JTech-CO/Smart-Cart-Wiring/tests/desktop.png

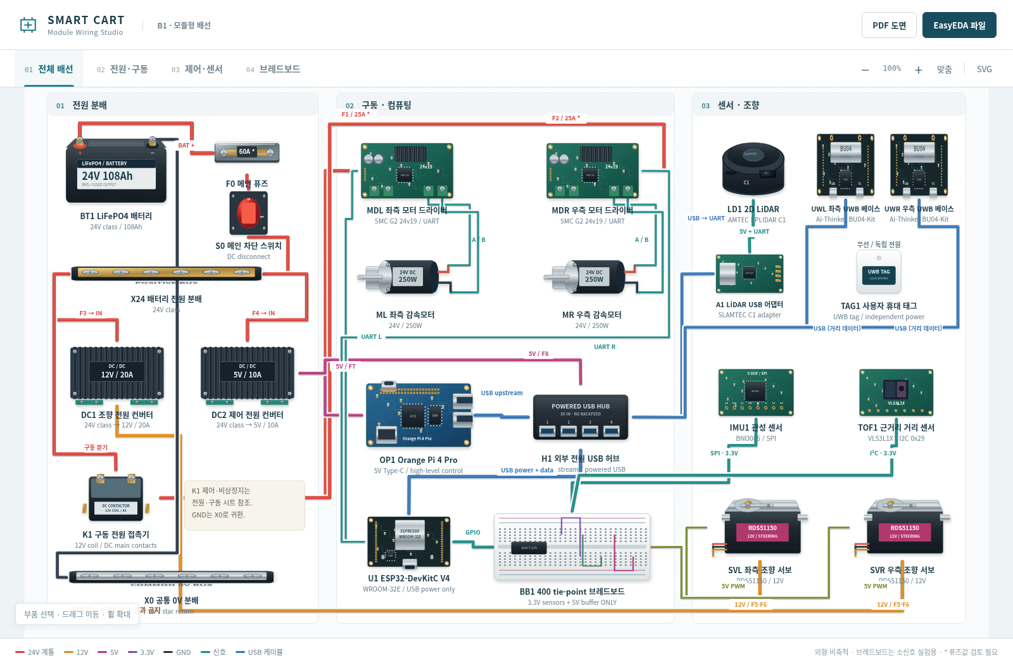
tests/desktop.png
