JTech-CO/Smart-Cart-Wiring/docs/SOURCES.md

# Primary sources / 기본 참조

검토일: 2026-09-13. 정확한 구매품 사양은 해당 제조사의 구매 모델 문서로 재확인합니다.

## S01 | Smart-Cart repository / 2b4b8fea6909e4f76b4a52b02c5075c3f478097b

https://github.com/JTech-CO/Smart-Cart/tree/2b4b8fea6909e4f76b4a52b02c5075c3f478097b

## S02 | Pololu G2 SMC user guide

https://www.pololu.com/docs/0J77/all

## S03 | ESP32-DevKitC V4 power and J2/J3 pin tables

https://docs.espressif.com/projects/esp-dev-kits/en/latest/esp32/esp32-devkitc/user_guide.html

## S04 | Adafruit BNO085 pinouts and SPI mode

https://learn.adafruit.com/adafruit-9-dof-orientation-imu-fusion-breakout-bno085/pinouts

## S05 | Pololu VL53L1X carrier #3415

https://www.pololu.com/product/3415

## S06 | Ai-Thinker BU04-Kit specification v1.1.0, p9 USB port

https://en.ai-thinker.com/Uploads/file/20241018/20241018150326_27432.pdf

## S07 | TI SN74AHCT125 datasheet

https://www.ti.com/lit/ds/symlink/sn74ahct125.pdf

## S08 | EasyEDA Standard document format

https://docs.easyeda.com/en/DocumentFormat/EasyEDA-Format-Standard/index.html

## S09 | EasyEDA Pro import EasyEDA Standard JSON / ZIP

https://prodocs.easyeda.com/en/import-export/import-easyeda/

## S10 | EasyEDA Pro KiCad 5.1 import

https://prodocs.easyeda.com/en/import-export/import-kicad/

## S11 | Infineon BTS7960 operating voltage

https://www.infineon.com/dgdl/BTS7960_Datasheet.pdf

## S12 | SLAMTEC C1 datasheet

https://d229kd5ey79jzj.cloudfront.net/3157/SLAMTEC_rplidar_datasheet_C1_v1.0_en.pdf

RDS51150, 배터리/BMS, DC-DC, 허브, 접촉기는 정확한 구매 SKU가 없어 조건부 항목으로 표기했습니다.
