JTech-CO/Smart-Cart-Wiring/docs/ASSEMBLY-KR.md

# B1 모듈 조립 참조 및 미확정 항목

## 설계 기준과 출처

Smart-Cart 저장소 main의 `2b4b8fea6909e4f76b4a52b02c5075c3f478097b`를 참조했습니다. 해당 저장소는 사진 기반 절차적 WebGL 뷰어이며 전장 회로나 FreeCAD 치수 원본이 아닙니다. 코드나 기존 이미지의 라이선스를 새로 지정하거나 그대로 가져오지 않았습니다. 본 도면의 외형 재구성 역시 실측·제품 CAD가 아닙니다.

원래 카트의 후륜 차동 구동·전륜 자유 캐스터와 조향 서보 2개 요구를 구분합니다. 두 서보는 보존했으나 조향 링크·조향 끝점·차동 구동과의 운동학을 정하기 전에는 동력 조향을 활성화하지 않습니다.

## 배선 기준

전력 하네스는 BAT+, BUS24, DRIVE24, P12, P5, GND로 구분합니다. 전원 -의 공통화와 서로 다른 +전원 합선은 다릅니다. 컨버터는 비절연형을 가정했으며 다른 제품 사용 시 공통 접지/통신 기준을 다시 검토합니다. 모터 A/B는 H브리지 출력이라 어느 쪽도 상시 GND가 아닙니다.

SBC·서보·모터 전류는 브레드보드를 거치지 않습니다. 각 귀환은 X0의 적절한 전력 분기로 보내며 신호 점퍼를 대전류 귀환으로 이용하지 않습니다. 그림의 케이블 굵기는 시각 구분이고 AWG 선정값이 아닙니다. 길이, 주위 온도, 번들링, 단자 전류, 전압 강하, 퓨즈 시간-전류 곡선과 단락 차단용량을 확보한 뒤 도체 단면을 확정합니다.

## 전원과 정지

BT1은 기존 24V 클래스 108Ah 요구입니다. 배터리 실모델·직렬 수·BMS 방전/충전 허용 전류·충전 상한은 미확정입니다. 8S LiFePO4로 구성하면 공칭 25.6V이며 최대 충전 전압은 배터리 제조사에 따라 확인해야 합니다. 용량 Ah를 허용 방전 A로 취급하지 않습니다.

BTS7960의 정상 입력 전압 범위(5.5~27.5V)는 완충 8S 배터리와 여유가 부족하므로 기본 구성에서 제외했습니다. SMC G2 24v19는 조건부 참조이며, 실제 연속 전류·스톨·방열·재생 제동 검증이 필요합니다. 제조사의 포함 단자대 15~16A 안내 때문에 25A 퓨즈가 적힌 분기를 해당 단자대에 그대로 승인하지 않았습니다. 적합한 고전류 접속 또는 드라이버 변경이 필요합니다. [S02, S11]

DC1: 12V/20A, DC2: 5V/10A는 목표 출력입니다. 입력 허용 범위가 완충 및 과도전압을 포함해야 하고, 연속 출력 열조건·단락·과전압 보호·부하 급변 응답은 실모델로 확인해야 합니다. 12V 서보 2개의 지속 스톨을 퓨즈만으로 보호할 수는 없습니다.

K1은 12V 코일과 독립 NO 보조접점이 있는 DC 접촉기를 가정합니다. P12→F9→S1 NC→(S2 NO || K1 13-14)→A1, A2→GND가 자기유지 기능 회로입니다. Z1은 K1 지정 코일 억제기입니다. S1 복귀만으로 코일을 재여자하지 않지만, 단일 접점 용착·배선 단락까지 안전을 보장하는 인증 회로가 아닙니다. 전원 차단은 제동이 아니며 조향 전원은 유지됩니다. K1 개방/배터리 완충/BMS 차단 시 회생 에너지 처리와 별도 브레이크를 반드시 설계해야 합니다.

## 제어·센서

ESP32-DevKitC V4 WROOM-32E는 허브 USB로만 급전합니다. 5V 헤더와 다른 USB 전원을 추가 병렬 급전하지 않습니다. J2/J3 번호는 Espressif V4 보드의 표 기준이며 다른 DevKit·WROVER·클론은 회로/핀맵을 다시 확인합니다. [S03]

Orange Pi는 외부 5V 전원 입력을 사용합니다. 외부 전원 4포트 허브는 upstream 역급전 방지와 포트별 전류 조건이 있는 제품이어야 합니다. 4포트는 ESP32, C1 어댑터, UWB L, UWB R에 각각 할당합니다. USB D±는 완성 케이블로 배선하고 브레드보드를 통과하지 않습니다. C1의 기동 전류와 허브 포트 한도·케이블 손실을 시험합니다.

BU04-Kit의 USB/거리 데이터 포트와 TTL/AT 포트는 다릅니다. 여기서는 USB 거리 데이터 포트를 연결합니다. bare BU04나 다른 Follow Package를 동일 회로로 간주하지 않습니다. 사용자 태그는 별도 배터리입니다. 2개 베이스와 1개 태그의 동시 측정/동기화/ID는 해당 펌웨어에서 검증해야 합니다. [S06]

IMU는 Adafruit BNO085 #4754 SPI 기준입니다. VIN 3.3V, P0/P1 HIGH, SCL=SCK, DI=MOSI, SDA=MISO, CS/INT/RST 사용. 3Vo 출력은 외부 전원에 연결하지 않습니다. ToF는 Pololu #3415의 VIN 3.3V·I2C 기준이고 XSHUT/GPIO1/VDD는 NC입니다. 두 제품의 자체 레귤레이터 출력과 입력을 혼동하지 않습니다. [S04, S05]

서보 PWM은 SN74AHCT125N 5V 버퍼를 통해 공급합니다. GPIO13/14에 10kΩ 풀다운을 두고, 버퍼 출력에 220Ω 직렬 저항을 둡니다. DIP 8/11번 출력은 NC, 9/12번 입력은 GND, 10/13번 /OE는 5V입니다. 제조사 핀 표와 실제 패키지 노치 방향을 확인합니다. RDS51150 실제 모델의 5V PWM 허용/선 순서/피드백선과 기구 끝점은 미확정입니다. [S07]

UART 직렬 저항은 TX에 1kΩ이며 완전한 전원 분리/역급전 방지 소자가 아닙니다. 드라이버 또는 ESP32 전원이 없는 상태의 통신선 전압과 역급전, 명령 timeout 및 safe-start를 실측 검증합니다.

## 브레드보드 위치 규칙

400접점 기준: 본체 30열×10행=300개, 전원 레일 25개×4줄=100개. 상부 T+/T-, 하부 B+/B- 레일은 각각 왼쪽부터 1~25번으로 세며 본체 열 번호와 혼용하지 않습니다. 실제 구매 브레드보드의 레일 개수·분할·배치는 무전원 도통 검사로 확인합니다.

T+는 ESP32 3.3V, B+는 F10에서 오는 5V 버퍼 전원입니다. T-25와 B-25만 공통 음극 점퍼로 연결합니다. IC U2는 e3~e9 / f3~f9에 걸치며 1번=e3, 7번=e9, 8번=f9, 14번=f3입니다. `data/breadboard-contacts.csv`가 84개 사용 접점과 연결 리드의 전체 목록입니다. 저항의 긴 다리를 서로 접촉시키지 말고 노출 구간을 절연/정리합니다.

## 첫 통전 전

1. 배터리를 분리하고 모든 전원 레일의 극성, 분배 블록의 도통, 각 퓨즈 전단/후단과 스위치 우회선 부재를 확인합니다.
2. 전류 제한 전원으로 DC-DC를 단독 시험하고, 센서/USB/ESP32를 한 모듈씩 연결하여 전압과 발열을 확인합니다.
3. 모터를 바퀴가 안전하게 뜬 상태에서 제한 전류로 시험합니다. 스톨을 손으로 강제로 만들지 않습니다.
4. 조향 끝점과 링크를 검증한 후 서보를 시험합니다. 두 서보가 서로 맞서는 토크를 지속하지 않게 합니다.
5. 비상정지, 통신 끊김, 제어보드 재부팅, 태그 상실, 명령 timeout, 수동 재무장을 시험합니다. 탑승 시험이나 경사로 시험은 별도 기계/제동 검토 전 실시하지 않습니다.

정적 연결 검사는 전력 정격이나 고장 시 안전성을 검증하는 시험이 아닙니다. 이 파일은 조건부 벤치 설계이므로 전장 담당자의 제작 승인과 실측 검증이 필요합니다.
