JTech-CO/Smart-Cart-Wiring/tests/breadboard-view.png

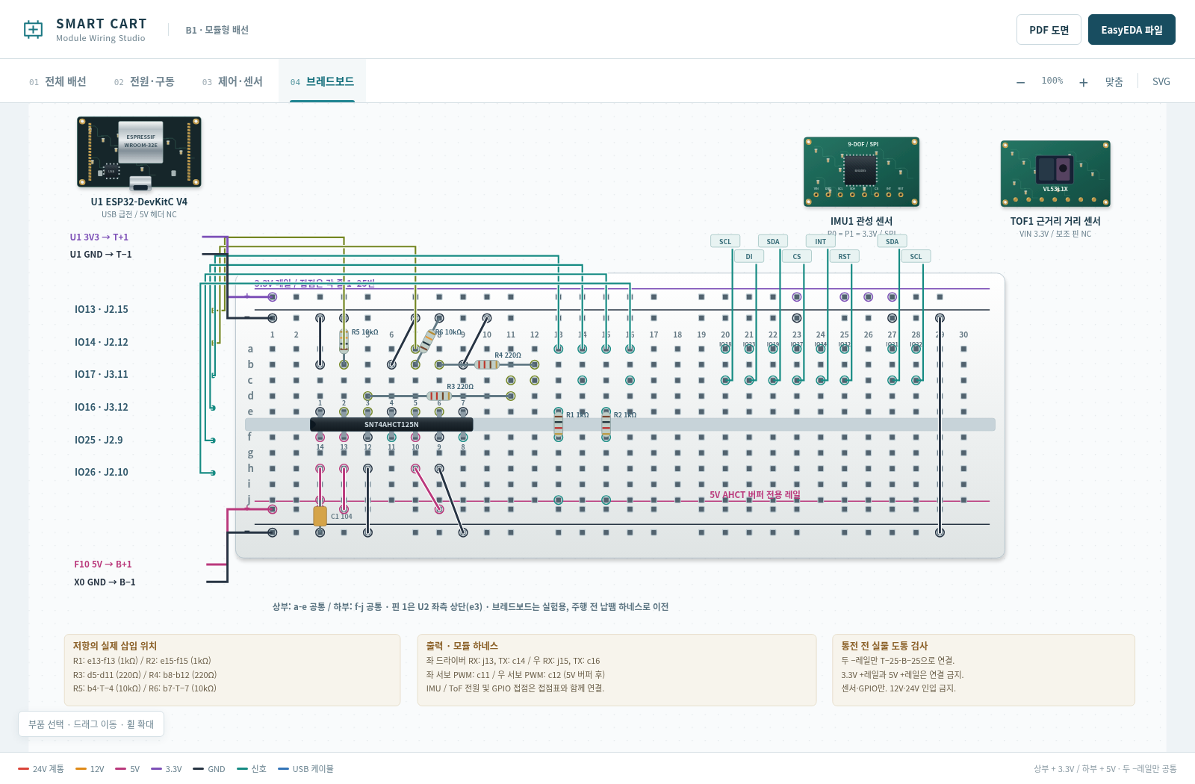
tests/breadboard-view.png
