JTech-CO/Smart-Cart-Wiring/tests/mobile.png

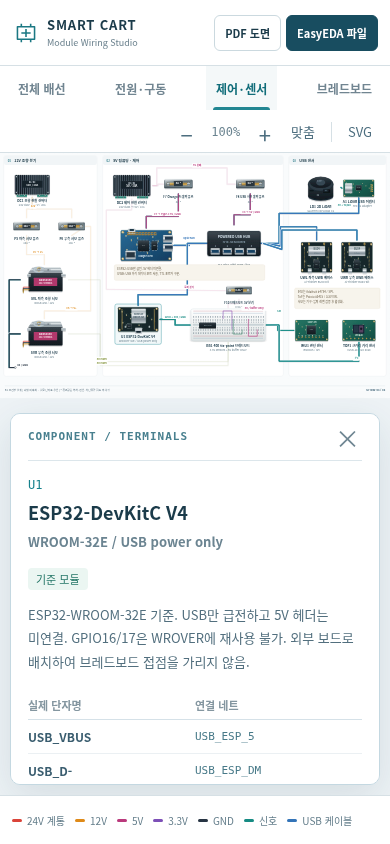
tests/mobile.png
