JTech-CO/Smart-Cart-Wiring/docs/CHANGELOG.md

# B1 변경 사항

PCB 신호 허브/제조 패키지를 모듈·퓨즈·단자대·브레드보드 참조로 교체했습니다. 추종 시뮬레이션·전력 예산 UI·체크리스트 편집·PCB 레이어·고급 대시보드를 제거했습니다. 400접점의 전원 레일은 본체와 별도로 25개씩 번호를 매겼습니다. GPIO13/14 서보 신호를 AHCT 5V 버퍼로 처리하고 조향 서보 2개는 기계 구조 검증이 필요한 조건부로 보존했습니다. UWB 2개는 BU04-Kit USB 거리 데이터 포트, 사용자 태그는 별도 전원입니다. 별도의 구매 회로/키트에는 동일 핀맵을 적용하지 않습니다.

B1은 Smart-Cart 저장소를 참조한 별도 정적 웹앱 패키지입니다. 원본 저장소를 변경하지 않았고 원본의 라이선스를 새로 부여하지 않았습니다. PCB 제조 파일이나 안전 인증은 포함하지 않습니다.
