JTech-CO/Smart-Cart-Wiring/(list of files, drawings)

Other design files:
eda/easyeda/SmartCart-B1-Modules.json
