JTech-CO/Smart-Cart-Wiring/eda/kicad/SmartCart.sch

## KiCad design eda/kicad/SmartCart.sch (2026-09-13)

Schematic: SmartCart.sch

Parts:
A1: SLAMTEC C1 adapter
BT1: 24V class / 108Ah
C1: 100nF / >=16V
DC1: 24V class -> 12V / 20A
DC2: 24V class -> 5V / 10A
F0: 60A *
F1, F2: 25A *
F3: 15A *
F4: 5A *
F5, F6: 10A *
F7, F8: 4A *
F9: 1A *
F10: 0.5A *
H1: 4 downstream / powered USB
IMU1: BNO085 / SPI
K1: 12V coil / DC main contacts
LD1: SLAMTEC RPLIDAR C1
MDL: SMC G2 24v19 / UART
MDR: SMC G2 24v19 / UART
ML: 24V / 250W
MR: 24V / 250W
OP1: 5V Type-C / high-level control
R1, R2: 1kohm / 0.25W
R3, R4: 220ohm / 0.25W
R5, R6: 10kohm / 0.25W
S0: DC disconnect
S1: NC / twist reset
S2: momentary NO
SVL: RDS51150 / 12V
SVR: RDS51150 / 12V
TOF1: VL53L1X / I2C 0x29
U1: WROOM-32E / USB power only
U2: SN74AHCT125N / DIP-14
UWL: Ai-Thinker BU04-Kit
UWR: Ai-Thinker BU04-Kit
X0: 0V / star return
X24: 24V class
Z1: K1 지정품

Connections:
BAT_FUSED: F0.2, S0.1
BAT_POS: BT1.1 (+), F0.1
BUS24: F3.1, F4.1, K1.1 (L1), S0.2, X24.1 (IN), X24.2 (K1), X24.3 (F3), X24.4 (F4)
COIL12: K1.3 (A1), K1.6 (14), S2.2, Z1.1
COIL_FUSED: F9.2, S1.1
DC5_IN: DC2.1 (IN+), F4.2
DC12_IN: DC1.1 (IN+), F3.2
DRIVE24: F1.1, F2.1, K1.2 (T1)
ESP_L_TX: R1.1, U1.7 (J3.11___IO17)
ESP_R_TX: R2.1, U1.9 (J2.9___IO25)
GND: A1.4 (USB_GND), A1.6 (GND_OUT), BT1.2 (-), C1.2, DC1.2 (IN-), DC1.4 (OUT-), DC2.2 (IN-), DC2.4 (OUT-), H1.2 (DC-), H1.6 (UP_GND), H1.10 (P1_GND), H1.14 (P2_GND), H1.18 (P3_GND), H1.22 (P4_GND), IMU1.2 (GND), K1.4 (A2), LD1.2 (GND), MDL.2 (GND), MDR.2 (GND), OP1.2 (PWR-GND), OP1.6 (HOST_GND), R5.2, R6.2, SVL.2 (GND), SVR.2 (GND), TOF1.2 (GND), U1.4 (USB_GND), U1.6 (J2.14___GND), U2.1 (1___1OE), U2.4 (4___2OE), U2.7 (7___GND), U2.9 (9___3A), U2.12 (12___4A), UWL.4 (USB_GND), UWR.4 (USB_GND), X0.1, X0.2, X0.3, X0.4, X0.5, X0.6, X0.7, X0.8, X0.9, X0.10, X0.11, X0.12, Z1.2
HOST5: H1.3 (UP_VBUS_SENSE), OP1.3 (HOST_VBUS)
HOST_DM: H1.4 (UP_D-), OP1.4 (HOST_D-)
HOST_DP: H1.5 (UP_D+), OP1.5 (HOST_D+)
HUB5: F8.2, H1.1 (DC+)
IMU_CS: IMU1.6 (CS), U1.14 (J2.11___IO27)
IMU_INT: IMU1.7 (INT), U1.15 (J2.5___IO34)
IMU_MISO: IMU1.5 (SDA___MISO), U1.13 (J3.8___IO19)
IMU_MOSI: IMU1.4 (DI___MOSI), U1.12 (J3.2___IO23)
IMU_RST: IMU1.8 (RST), U1.16 (J2.7___IO32)
IMU_SCK: IMU1.3 (SCL___SCK), U1.11 (J3.9___IO18)
LATCH_IN: K1.5 (13), S1.2, S2.1
LIDAR_RX: A1.7 (TX_3V3), LD1.4 (RX)
LIDAR_TX: A1.8 (RX_3V3), LD1.3 (TX)
LOGIC5: C1.1, F10.2, U2.10 (10___3OE), U2.13 (13___4OE), U2.14 (14___VCC)
ML_A: MDL.3 (OUTA), ML.1 (A)
ML_B: MDL.4 (OUTB), ML.2 (B)
ML_RX: MDL.5 (RX), R1.2
ML_TX: MDL.6 (TX), U1.8 (J3.12___IO16)
ML_VIN: F1.2, MDL.1 (VIN)
MR_A: MDR.3 (OUTA), MR.1 (A)
MR_B: MDR.4 (OUTB), MR.2 (B)
MR_RX: MDR.5 (RX), R2.2
MR_TX: MDR.6 (TX), U1.10 (J2.10___IO26)
MR_VIN: F2.2, MDR.1 (VIN)
NC_U2_8: U2.8 (8___3Y)
NC_U2_11: U2.11 (11___4Y)
OPI5: F7.2, OP1.1 (PWR+)
P3V3: IMU1.1 (VIN), IMU1.9 (P0), IMU1.10 (P1), TOF1.1 (VIN), U1.5 (J2.1___3V3)
P5: DC2.3 (OUT+), F7.1, F8.1, F10.1
P12: DC1.3 (OUT+), F5.1, F6.1, F9.1
PWM_L_3V3: R5.1, U1.19 (J2.15___IO13), U2.2 (2___1A)
PWM_L_5V: R3.1, U2.3 (3___1Y)
PWM_R_3V3: R6.1, U1.20 (J2.12___IO14), U2.5 (5___2A)
PWM_R_5V: R4.1, U2.6 (6___2Y)
SERVO_L: R3.2, SVL.3 (PWM)
SERVO_R: R4.2, SVR.3 (PWM)
SVL_PWR: F5.2, SVL.1 (V+)
SVR_PWR: F6.2, SVR.1 (V+)
TOF_SCL: TOF1.4 (SCL), U1.18 (J3.3___IO22)
TOF_SDA: TOF1.3 (SDA), U1.17 (J3.6___IO21)
USB_ESP_5: H1.7 (P1_VBUS), U1.1 (USB_VBUS)
USB_ESP_DM: H1.8 (P1_D-), U1.2 (USB_D-)
USB_ESP_DP: H1.9 (P1_D+), U1.3 (USB_D+)
USB_LIDAR_5: A1.1 (USB_VBUS), A1.5 (5V_OUT), H1.11 (P2_VBUS), LD1.1 (5V)
USB_LIDAR_DM: A1.2 (USB_D-), H1.12 (P2_D-)
USB_LIDAR_DP: A1.3 (USB_D+), H1.13 (P2_D+)
USB_UWBL_5: H1.15 (P3_VBUS), UWL.1 (USB_VBUS)
USB_UWBL_DM: H1.16 (P3_D-), UWL.2 (USB_D-)
USB_UWBL_DP: H1.17 (P3_D+), UWL.3 (USB_D+)
USB_UWBR_5: H1.19 (P4_VBUS), UWR.1 (USB_VBUS)
USB_UWBR_DM: H1.20 (P4_D-), UWR.2 (USB_D-)
USB_UWBR_DP: H1.21 (P4_D+), UWR.3 (USB_D+)
