JTech-CO/Smart-Cart-Wiring/js/design.js

window.CART_DESIGN = {"name": "Smart Cart Wiring Studio", "revision": "B1", "date": "2026-09-13", "repo_commit": "2b4b8fea6909e4f76b4a52b02c5075c3f478097b", "components": [{"ref": "BT1", "name": "LiFePO4 배터리", "kind": "battery", "pins": [{"number": "1", "name": "+", "net": "BAT_POS"}, {"number": "2", "name": "-", "net": "GND"}], "notes": "기존 도면의 24V 108Ah를 유지. 실제 모델·BMS 정격 미확정. 8S라면 공칭 25.6V, 충전 상한은 제조사 확인.", "spec": "24V class / 108Ah", "status": "candidate", "page": "power"}, {"ref": "F0", "name": "메인 퓨즈", "kind": "fuse", "pins": [{"number": "1", "name": "1", "net": "BAT_POS"}, {"number": "2", "name": "2", "net": "BAT_FUSED"}], "notes": "배터리 + 가까이 설치. 60A는 검토값. DC 전압·차단용량·전선 보호 협조 확정 전 통전 금지.", "spec": "60A *", "status": "candidate", "page": "power"}, {"ref": "S0", "name": "메인 차단 스위치", "kind": "switch", "pins": [{"number": "1", "name": "1", "net": "BAT_FUSED"}, {"number": "2", "name": "2", "net": "BUS24"}], "notes": "전류 정격과 DC 부하 차단 능력 확인. 배터리 -는 외부 공통 0V 버스로 연결.", "spec": "DC disconnect", "status": "candidate", "page": "power"}, {"ref": "X24", "name": "배터리 전원 분배", "kind": "bus", "pins": [{"number": "1", "name": "IN", "net": "BUS24"}, {"number": "2", "name": "K1", "net": "BUS24"}, {"number": "3", "name": "F3", "net": "BUS24"}, {"number": "4", "name": "F4", "net": "BUS24"}], "notes": "절연 커버가 있는 양극 전용 버스. 음극 버스와 물리적으로 분리.", "spec": "24V class", "status": "candidate", "page": "power"}, {"ref": "X0", "name": "공통 0V 분배", "kind": "groundbus", "pins": [{"number": "1", "name": "1", "net": "GND"}, {"number": "2", "name": "2", "net": "GND"}, {"number": "3", "name": "3", "net": "GND"}, {"number": "4", "name": "4", "net": "GND"}, {"number": "5", "name": "5", "net": "GND"}, {"number": "6", "name": "6", "net": "GND"}, {"number": "7", "name": "7", "net": "GND"}, {"number": "8", "name": "8", "net": "GND"}, {"number": "9", "name": "9", "net": "GND"}, {"number": "10", "name": "10", "net": "GND"}, {"number": "11", "name": "11", "net": "GND"}, {"number": "12", "name": "12", "net": "GND"}], "notes": "비절연 DC-DC 기준. 모터·서보 귀환은 이 버스로 직접 연결. 브레드보드를 대전류 귀환 경로로 사용하지 않음.", "spec": "0V / star return", "status": "candidate", "page": "power"}, {"ref": "K1", "name": "구동 전원 접촉기", "kind": "contactor", "pins": [{"number": "1", "name": "L1", "net": "BUS24"}, {"number": "2", "name": "T1", "net": "DRIVE24"}, {"number": "3", "name": "A1", "net": "COIL12"}, {"number": "4", "name": "A2", "net": "GND"}, {"number": "5", "name": "13", "net": "LATCH_IN"}, {"number": "6", "name": "14", "net": "COIL12"}], "notes": "12V 코일과 별도 NO 보조접점이 필요. DC 주접점 정격은 최종 선정. E-stop은 구동전원 차단이며 제동 보장은 아님.", "spec": "12V coil / DC main contacts", "status": "candidate", "page": "power"}, {"ref": "F1", "name": "좌측 모터 입력 퓨즈", "kind": "fuse", "pins": [{"number": "1", "name": "1", "net": "DRIVE24"}, {"number": "2", "name": "2", "net": "ML_VIN"}], "notes": "", "spec": "25A *", "status": "candidate", "page": "power"}, {"ref": "F2", "name": "우측 모터 입력 퓨즈", "kind": "fuse", "pins": [{"number": "1", "name": "1", "net": "DRIVE24"}, {"number": "2", "name": "2", "net": "MR_VIN"}], "notes": "", "spec": "25A *", "status": "candidate", "page": "power"}, {"ref": "MDL", "name": "좌측 모터 드라이버", "kind": "driver", "pins": [{"number": "1", "name": "VIN", "net": "ML_VIN"}, {"number": "2", "name": "GND", "net": "GND"}, {"number": "3", "name": "OUTA", "net": "ML_A"}, {"number": "4", "name": "OUTB", "net": "ML_B"}, {"number": "5", "name": "RX", "net": "ML_RX"}, {"number": "6", "name": "TX", "net": "ML_TX"}], "notes": "Pololu G2 SMC 24v19를 조건부 기준으로 사용. 정상 권장 상한 34V. 19A 연속값은 조건부이며 스톨·열·회생은 별도 검증. 포함 단자대는 제조사 15~16A 안내가 있어 25A 보호분기에는 그대로 승인하지 않음. UART timeout, safe-start 설정 필요.", "spec": "SMC G2 24v19 / UART", "status": "conditional", "page": "power"}, {"ref": "ML", "name": "좌측 감속모터", "kind": "motor", "pins": [{"number": "1", "name": "A", "net": "ML_A"}, {"number": "2", "name": "B", "net": "ML_B"}], "notes": "24V 250W 브러시드 DC 감속모터 가정. 극성은 바퀴를 띄운 상태에서 확인. 스톨 전류 미확정.", "spec": "24V / 250W", "status": "candidate", "page": "power"}, {"ref": "MDR", "name": "우측 모터 드라이버", "kind": "driver", "pins": [{"number": "1", "name": "VIN", "net": "MR_VIN"}, {"number": "2", "name": "GND", "net": "GND"}, {"number": "3", "name": "OUTA", "net": "MR_A"}, {"number": "4", "name": "OUTB", "net": "MR_B"}, {"number": "5", "name": "RX", "net": "MR_RX"}, {"number": "6", "name": "TX", "net": "MR_TX"}], "notes": "Pololu G2 SMC 24v19를 조건부 기준으로 사용. 정상 권장 상한 34V. 19A 연속값은 조건부이며 스톨·열·회생은 별도 검증. 포함 단자대는 제조사 15~16A 안내가 있어 25A 보호분기에는 그대로 승인하지 않음. UART timeout, safe-start 설정 필요.", "spec": "SMC G2 24v19 / UART", "status": "conditional", "page": "power"}, {"ref": "MR", "name": "우측 감속모터", "kind": "motor", "pins": [{"number": "1", "name": "A", "net": "MR_A"}, {"number": "2", "name": "B", "net": "MR_B"}], "notes": "24V 250W 브러시드 DC 감속모터 가정. 극성은 바퀴를 띄운 상태에서 확인. 스톨 전류 미확정.", "spec": "24V / 250W", "status": "candidate", "page": "power"}, {"ref": "F3", "name": "12V 컨버터 입력 퓨즈", "kind": "fuse", "pins": [{"number": "1", "name": "1", "net": "BUS24"}, {"number": "2", "name": "2", "net": "DC12_IN"}], "notes": "", "spec": "15A *", "status": "candidate", "page": "power"}, {"ref": "F4", "name": "5V 컨버터 입력 퓨즈", "kind": "fuse", "pins": [{"number": "1", "name": "1", "net": "BUS24"}, {"number": "2", "name": "2", "net": "DC5_IN"}], "notes": "", "spec": "5A *", "status": "candidate", "page": "power"}, {"ref": "DC1", "name": "조향 전원 컨버터", "kind": "converter", "pins": [{"number": "1", "name": "IN+", "net": "DC12_IN"}, {"number": "2", "name": "IN-", "net": "GND"}, {"number": "3", "name": "OUT+", "net": "P12"}, {"number": "4", "name": "OUT-", "net": "GND"}], "notes": "입력은 배터리 완충 및 과도전압을 허용해야 함. 12V 20A 연속 출력, 방열 및 동시 서보 스톨 확인. 비절연형 기준.", "spec": "24V class → 12V / 20A", "status": "candidate", "page": "power"}, {"ref": "DC2", "name": "제어 전원 컨버터", "kind": "converter", "pins": [{"number": "1", "name": "IN+", "net": "DC5_IN"}, {"number": "2", "name": "IN-", "net": "GND"}, {"number": "3", "name": "OUT+", "net": "P5"}, {"number": "4", "name": "OUT-", "net": "GND"}], "notes": "입력 범위·출력 과전압 보호·연속 출력 사양 확인. 5V는 부하 단자에서 측정. 비절연형 기준.", "spec": "24V class → 5V / 10A", "status": "candidate", "page": "power"}, {"ref": "F5", "name": "좌측 서보 퓨즈", "kind": "fuse", "pins": [{"number": "1", "name": "1", "net": "P12"}, {"number": "2", "name": "2", "net": "SVL_PWR"}], "notes": "", "spec": "10A *", "status": "candidate", "page": "power"}, {"ref": "SVL", "name": "좌측 조향 서보", "kind": "servo", "pins": [{"number": "1", "name": "V+", "net": "SVL_PWR"}, {"number": "2", "name": "GND", "net": "GND"}, {"number": "3", "name": "PWM", "net": "SERVO_L"}], "notes": "RDS51150 12V형 조건부. 실제 선 색·순서·피드백 선 유무·5V PWM 허용 여부 확인. 기존 저장소는 자유 캐스터 차동 구동이므로 조향 링크를 확정하기 전 장착 구동 금지.", "spec": "RDS51150 / 12V", "status": "conditional", "page": "power"}, {"ref": "F6", "name": "우측 서보 퓨즈", "kind": "fuse", "pins": [{"number": "1", "name": "1", "net": "P12"}, {"number": "2", "name": "2", "net": "SVR_PWR"}], "notes": "", "spec": "10A *", "status": "candidate", "page": "power"}, {"ref": "SVR", "name": "우측 조향 서보", "kind": "servo", "pins": [{"number": "1", "name": "V+", "net": "SVR_PWR"}, {"number": "2", "name": "GND", "net": "GND"}, {"number": "3", "name": "PWM", "net": "SERVO_R"}], "notes": "RDS51150 12V형 조건부. 실제 선 색·순서·피드백 선 유무·5V PWM 허용 여부 확인. 기존 저장소는 자유 캐스터 차동 구동이므로 조향 링크를 확정하기 전 장착 구동 금지.", "spec": "RDS51150 / 12V", "status": "conditional", "page": "power"}, {"ref": "F7", "name": "Orange Pi 출력 퓨즈", "kind": "fuse", "pins": [{"number": "1", "name": "1", "net": "P5"}, {"number": "2", "name": "2", "net": "OPI5"}], "notes": "", "spec": "4A *", "status": "candidate", "page": "power"}, {"ref": "F8", "name": "USB 허브 출력 퓨즈", "kind": "fuse", "pins": [{"number": "1", "name": "1", "net": "P5"}, {"number": "2", "name": "2", "net": "HUB5"}], "notes": "", "spec": "4A *", "status": "candidate", "page": "power"}, {"ref": "F9", "name": "접촉기 코일 퓨즈", "kind": "fuse", "pins": [{"number": "1", "name": "1", "net": "P12"}, {"number": "2", "name": "2", "net": "COIL_FUSED"}], "notes": "", "spec": "1A *", "status": "candidate", "page": "power"}, {"ref": "F10", "name": "브레드보드 5V 분기", "kind": "fuse", "pins": [{"number": "1", "name": "1", "net": "P5"}, {"number": "2", "name": "2", "net": "LOGIC5"}], "notes": "5V는 AHCT 버퍼에만 공급. 서보·SBC 전원은 브레드보드를 통과하지 않음.", "spec": "0.5A *", "status": "candidate", "page": "power"}, {"ref": "S1", "name": "비상정지 버튼", "kind": "estop", "pins": [{"number": "1", "name": "1", "net": "COIL_FUSED"}, {"number": "2", "name": "2", "net": "LATCH_IN"}], "notes": "래칭 NC 접점. 해제만으로 재출발하지 않으며 S2를 다시 눌러야 접촉기가 유지됨.", "spec": "NC / twist reset", "status": "candidate", "page": "power"}, {"ref": "S2", "name": "수동 재무장 버튼", "kind": "start", "pins": [{"number": "1", "name": "1", "net": "LATCH_IN"}, {"number": "2", "name": "2", "net": "COIL12"}], "notes": "K1 NO 보조접점 13-14와 병렬. 이것은 단일 채널 기능 회로이며 인증된 안전 회로가 아님.", "spec": "momentary NO", "status": "candidate", "page": "power"}, {"ref": "Z1", "name": "코일 서지 억제 모듈", "kind": "suppressor", "pins": [{"number": "1", "name": "1", "net": "COIL12"}, {"number": "2", "name": "2", "net": "GND"}], "notes": "코일 전압·클램프·접촉기 해제시간에 맞는 제조사 지정 억제기. 임의 플라이백 다이오드로 대체 금지.", "spec": "K1 지정품", "status": "candidate", "page": "power"}, {"ref": "OP1", "name": "Orange Pi 4 Pro", "kind": "opi", "pins": [{"number": "1", "name": "PWR+", "net": "OPI5"}, {"number": "2", "name": "PWR-GND", "net": "GND"}, {"number": "3", "name": "HOST_VBUS", "net": "HOST5"}, {"number": "4", "name": "HOST_D-", "net": "HOST_DM"}, {"number": "5", "name": "HOST_D+", "net": "HOST_DP"}, {"number": "6", "name": "HOST_GND", "net": "GND"}], "notes": "전원용 Type-C 5V 입력 사용. 호스트 USB는 외부 전원 허브의 upstream에 연결. 보드의 USB 포트 전류 한도로 전체 센서를 급전하지 않음.", "spec": "5V Type-C / high-level control", "status": "reference", "page": "signal"}, {"ref": "H1", "name": "외부 전원 USB 허브", "kind": "hub", "pins": [{"number": "1", "name": "DC+", "net": "HUB5"}, {"number": "2", "name": "DC-", "net": "GND"}, {"number": "3", "name": "UP_VBUS_SENSE", "net": "HOST5"}, {"number": "4", "name": "UP_D-", "net": "HOST_DM"}, {"number": "5", "name": "UP_D+", "net": "HOST_DP"}, {"number": "6", "name": "UP_GND", "net": "GND"}, {"number": "7", "name": "P1_VBUS", "net": "USB_ESP_5"}, {"number": "8", "name": "P1_D-", "net": "USB_ESP_DM"}, {"number": "9", "name": "P1_D+", "net": "USB_ESP_DP"}, {"number": "10", "name": "P1_GND", "net": "GND"}, {"number": "11", "name": "P2_VBUS", "net": "USB_LIDAR_5"}, {"number": "12", "name": "P2_D-", "net": "USB_LIDAR_DM"}, {"number": "13", "name": "P2_D+", "net": "USB_LIDAR_DP"}, {"number": "14", "name": "P2_GND", "net": "GND"}, {"number": "15", "name": "P3_VBUS", "net": "USB_UWBL_5"}, {"number": "16", "name": "P3_D-", "net": "USB_UWBL_DM"}, {"number": "17", "name": "P3_D+", "net": "USB_UWBL_DP"}, {"number": "18", "name": "P3_GND", "net": "GND"}, {"number": "19", "name": "P4_VBUS", "net": "USB_UWBR_5"}, {"number": "20", "name": "P4_D-", "net": "USB_UWBR_DM"}, {"number": "21", "name": "P4_D+", "net": "USB_UWBR_DP"}, {"number": "22", "name": "P4_GND", "net": "GND"}], "notes": "5V 외부 입력, 포트별 전류 제한, upstream VBUS 역급전 방지 제품 필요. USB 케이블은 완성품 사용. USB D±를 브레드보드에 배선하지 않음.", "spec": "4 downstream / powered USB", "status": "candidate", "page": "signal"}, {"ref": "U1", "name": "ESP32-DevKitC V4", "kind": "esp32", "pins": [{"number": "1", "name": "USB_VBUS", "net": "USB_ESP_5"}, {"number": "2", "name": "USB_D-", "net": "USB_ESP_DM"}, {"number": "3", "name": "USB_D+", "net": "USB_ESP_DP"}, {"number": "4", "name": "USB_GND", "net": "GND"}, {"number": "5", "name": "J2.1 / 3V3", "net": "P3V3"}, {"number": "6", "name": "J2.14 / GND", "net": "GND"}, {"number": "7", "name": "J3.11 / IO17", "net": "ESP_L_TX"}, {"number": "8", "name": "J3.12 / IO16", "net": "ML_TX"}, {"number": "9", "name": "J2.9 / IO25", "net": "ESP_R_TX"}, {"number": "10", "name": "J2.10 / IO26", "net": "MR_TX"}, {"number": "11", "name": "J3.9 / IO18", "net": "IMU_SCK"}, {"number": "12", "name": "J3.2 / IO23", "net": "IMU_MOSI"}, {"number": "13", "name": "J3.8 / IO19", "net": "IMU_MISO"}, {"number": "14", "name": "J2.11 / IO27", "net": "IMU_CS"}, {"number": "15", "name": "J2.5 / IO34", "net": "IMU_INT"}, {"number": "16", "name": "J2.7 / IO32", "net": "IMU_RST"}, {"number": "17", "name": "J3.6 / IO21", "net": "TOF_SDA"}, {"number": "18", "name": "J3.3 / IO22", "net": "TOF_SCL"}, {"number": "19", "name": "J2.15 / IO13", "net": "PWM_L_3V3"}, {"number": "20", "name": "J2.12 / IO14", "net": "PWM_R_3V3"}], "notes": "ESP32-WROOM-32E 기준. USB만 급전하고 5V 헤더는 미연결. GPIO16/17은 WROVER에 재사용 불가. 외부 보드로 배치하여 브레드보드 접점을 가리지 않음.", "spec": "WROOM-32E / USB power only", "status": "reference", "page": "signal"}, {"ref": "A1", "name": "LiDAR USB 어댑터", "kind": "adapter", "pins": [{"number": "1", "name": "USB_VBUS", "net": "USB_LIDAR_5"}, {"number": "2", "name": "USB_D-", "net": "USB_LIDAR_DM"}, {"number": "3", "name": "USB_D+", "net": "USB_LIDAR_DP"}, {"number": "4", "name": "USB_GND", "net": "GND"}, {"number": "5", "name": "5V_OUT", "net": "USB_LIDAR_5"}, {"number": "6", "name": "GND_OUT", "net": "GND"}, {"number": "7", "name": "TX_3V3", "net": "LIDAR_RX"}, {"number": "8", "name": "RX_3V3", "net": "LIDAR_TX"}], "notes": "C1용 정품 USB-UART 어댑터와 지정 케이블 사용. TX는 센서 RX, RX는 센서 TX로 교차.", "spec": "SLAMTEC C1 adapter", "status": "reference", "page": "signal"}, {"ref": "LD1", "name": "2D LiDAR", "kind": "lidar", "pins": [{"number": "1", "name": "5V", "net": "USB_LIDAR_5"}, {"number": "2", "name": "GND", "net": "GND"}, {"number": "3", "name": "TX", "net": "LIDAR_TX"}, {"number": "4", "name": "RX", "net": "LIDAR_RX"}], "notes": "RPLIDAR C1. 5V 전원과 3.3V UART를 구분. 센서 입력 4.8~5.2V 범위 검증.", "spec": "SLAMTEC RPLIDAR C1", "status": "reference", "page": "signal"}, {"ref": "UWL", "name": "좌측 UWB 베이스", "kind": "uwb", "pins": [{"number": "1", "name": "USB_VBUS", "net": "USB_UWBL_5"}, {"number": "2", "name": "USB_D-", "net": "USB_UWBL_DM"}, {"number": "3", "name": "USB_D+", "net": "USB_UWBL_DP"}, {"number": "4", "name": "USB_GND", "net": "GND"}], "notes": "BU04-Kit의 USB(거리 데이터) Type-C 포트 사용. TTL/AT 포트와 혼동하지 않음. bare BU04 및 별도 Follow Package는 동일 핀맵으로 간주하지 않음. 2베이스+1태그 동시 측정 펌웨어는 별도 설정.", "spec": "Ai-Thinker BU04-Kit", "status": "reference", "page": "signal"}, {"ref": "UWR", "name": "우측 UWB 베이스", "kind": "uwb", "pins": [{"number": "1", "name": "USB_VBUS", "net": "USB_UWBR_5"}, {"number": "2", "name": "USB_D-", "net": "USB_UWBR_DM"}, {"number": "3", "name": "USB_D+", "net": "USB_UWBR_DP"}, {"number": "4", "name": "USB_GND", "net": "GND"}], "notes": "BU04-Kit의 USB(거리 데이터) Type-C 포트 사용. TTL/AT 포트와 혼동하지 않음. bare BU04 및 별도 Follow Package는 동일 핀맵으로 간주하지 않음. 2베이스+1태그 동시 측정 펌웨어는 별도 설정.", "spec": "Ai-Thinker BU04-Kit", "status": "reference", "page": "signal"}, {"ref": "TAG1", "name": "사용자 휴대 태그", "kind": "tag", "pins": [], "notes": "독립 배터리로 동작. 카트 배터리와 유선 연결하지 않음. 베이스와 태그의 역할 및 ID는 펌웨어에서 설정.", "spec": "UWB tag / independent power", "status": "conditional", "page": "signal"}, {"ref": "IMU1", "name": "관성 센서", "kind": "imu", "pins": [{"number": "1", "name": "VIN", "net": "P3V3"}, {"number": "2", "name": "GND", "net": "GND"}, {"number": "3", "name": "SCL / SCK", "net": "IMU_SCK"}, {"number": "4", "name": "DI / MOSI", "net": "IMU_MOSI"}, {"number": "5", "name": "SDA / MISO", "net": "IMU_MISO"}, {"number": "6", "name": "CS", "net": "IMU_CS"}, {"number": "7", "name": "INT", "net": "IMU_INT"}, {"number": "8", "name": "RST", "net": "IMU_RST"}, {"number": "9", "name": "P0", "net": "P3V3"}, {"number": "10", "name": "P1", "net": "P3V3"}], "notes": "Adafruit BNO085 #4754 기준. P0/P1 모두 HIGH로 SPI 설정. 3Vo는 출력이므로 외부 전원과 병렬 연결하지 않음. INT/RST 포함.", "spec": "BNO085 / SPI", "status": "reference", "page": "signal"}, {"ref": "TOF1", "name": "근거리 거리 센서", "kind": "tof", "pins": [{"number": "1", "name": "VIN", "net": "P3V3"}, {"number": "2", "name": "GND", "net": "GND"}, {"number": "3", "name": "SDA", "net": "TOF_SDA"}, {"number": "4", "name": "SCL", "net": "TOF_SCL"}], "notes": "Pololu VL53L1X carrier #3415 기준. XSHUT, GPIO1, VDD는 미연결. 보드의 I2C 풀업 사용. XSHUT을 추가할 때는 2.8V 측 제약 확인.", "spec": "VL53L1X / I2C 0x29", "status": "reference", "page": "signal"}, {"ref": "R1", "name": "R1 1kΩ", "kind": "resistor", "pins": [{"number": "1", "name": "1", "net": "ESP_L_TX"}, {"number": "2", "name": "2", "net": "ML_RX"}], "notes": "", "spec": "1kΩ / 0.25W", "status": "reference", "page": "breadboard"}, {"ref": "R2", "name": "R2 1kΩ", "kind": "resistor", "pins": [{"number": "1", "name": "1", "net": "ESP_R_TX"}, {"number": "2", "name": "2", "net": "MR_RX"}], "notes": "", "spec": "1kΩ / 0.25W", "status": "reference", "page": "breadboard"}, {"ref": "R3", "name": "R3 220Ω", "kind": "resistor", "pins": [{"number": "1", "name": "1", "net": "PWM_L_5V"}, {"number": "2", "name": "2", "net": "SERVO_L"}], "notes": "", "spec": "220Ω / 0.25W", "status": "reference", "page": "breadboard"}, {"ref": "R4", "name": "R4 220Ω", "kind": "resistor", "pins": [{"number": "1", "name": "1", "net": "PWM_R_5V"}, {"number": "2", "name": "2", "net": "SERVO_R"}], "notes": "", "spec": "220Ω / 0.25W", "status": "reference", "page": "breadboard"}, {"ref": "R5", "name": "R5 10kΩ", "kind": "resistor", "pins": [{"number": "1", "name": "1", "net": "PWM_L_3V3"}, {"number": "2", "name": "2", "net": "GND"}], "notes": "", "spec": "10kΩ / 0.25W", "status": "reference", "page": "breadboard"}, {"ref": "R6", "name": "R6 10kΩ", "kind": "resistor", "pins": [{"number": "1", "name": "1", "net": "PWM_R_3V3"}, {"number": "2", "name": "2", "net": "GND"}], "notes": "", "spec": "10kΩ / 0.25W", "status": "reference", "page": "breadboard"}, {"ref": "U2", "name": "서보 PWM 레벨 버퍼", "kind": "buffer", "pins": [{"number": "1", "name": "1 / 1OE", "net": "GND"}, {"number": "2", "name": "2 / 1A", "net": "PWM_L_3V3"}, {"number": "3", "name": "3 / 1Y", "net": "PWM_L_5V"}, {"number": "4", "name": "4 / 2OE", "net": "GND"}, {"number": "5", "name": "5 / 2A", "net": "PWM_R_3V3"}, {"number": "6", "name": "6 / 2Y", "net": "PWM_R_5V"}, {"number": "7", "name": "7 / GND", "net": "GND"}, {"number": "8", "name": "8 / 3Y", "net": "NC_U2_8"}, {"number": "9", "name": "9 / 3A", "net": "GND"}, {"number": "10", "name": "10 / 3OE", "net": "LOGIC5"}, {"number": "11", "name": "11 / 4Y", "net": "NC_U2_11"}, {"number": "12", "name": "12 / 4A", "net": "GND"}, {"number": "13", "name": "13 / 4OE", "net": "LOGIC5"}, {"number": "14", "name": "14 / VCC", "net": "LOGIC5"}], "notes": "SN74AHCT125N DIP-14. 5V 전원, 3.3V TTL 입력. 미사용 출력 8/11번은 NC, 미사용 입력은 GND, 해당 OE는 5V. 핀1 표시 방향 확인.", "spec": "SN74AHCT125N / DIP-14", "status": "reference", "page": "breadboard"}, {"ref": "C1", "name": "버퍼 디커플링", "kind": "capacitor", "pins": [{"number": "1", "name": "1", "net": "LOGIC5"}, {"number": "2", "name": "2", "net": "GND"}], "notes": "U2 14-7번 전원 가까이.", "spec": "100nF / ≥16V", "status": "reference", "page": "breadboard"}, {"ref": "BB1", "name": "400 tie-point 브레드보드", "kind": "breadboard", "pins": [], "notes": "300개 본체 접점(30열 × 10행)과 100개 전원 레일 접점(25개 × 4줄). 레일은 각 줄 왼쪽부터 별도로 1~25번. a-e / f-j는 독립 5접점 스트립. 상부 +레일은 3.3V, 하부 +레일은 5V. 두 -레일만 공통. 모든 레일은 실물 도통 확인. 센서·로직 실험용이며 주행 차량에는 납땜/잠금 커넥터로 이전.", "spec": "3.3V sensors + 5V buffer ONLY", "status": "reference", "page": "breadboard"}], "breadboard": {"contacts": {"e3": {"net": "GND", "owner": "U2.1"}, "e4": {"net": "PWM_L_3V3", "owner": "U2.2"}, "e5": {"net": "PWM_L_5V", "owner": "U2.3"}, "e6": {"net": "GND", "owner": "U2.4"}, "e7": {"net": "PWM_R_3V3", "owner": "U2.5"}, "e8": {"net": "PWM_R_5V", "owner": "U2.6"}, "e9": {"net": "GND", "owner": "U2.7"}, "f9": {"net": "NC_U2_8", "owner": "U2.8"}, "f8": {"net": "GND", "owner": "U2.9"}, "f7": {"net": "LOGIC5", "owner": "U2.10"}, "f6": {"net": "NC_U2_11", "owner": "U2.11"}, "f5": {"net": "GND", "owner": "U2.12"}, "f4": {"net": "LOGIC5", "owner": "U2.13"}, "f3": {"net": "LOGIC5", "owner": "U2.14"}, "a13": {"net": "ESP_L_TX", "owner": "U1.IO17"}, "a14": {"net": "ML_TX", "owner": "U1.IO16"}, "a15": {"net": "ESP_R_TX", "owner": "U1.IO25"}, "a16": {"net": "MR_TX", "owner": "U1.IO26"}, "c14": {"net": "ML_TX", "owner": "MDL.TX"}, "c16": {"net": "MR_TX", "owner": "MDR.TX"}, "j13": {"net": "ML_RX", "owner": "MDL.RX"}, "j15": {"net": "MR_RX", "owner": "MDR.RX"}, "a4": {"net": "PWM_L_3V3", "owner": "U1.IO13"}, "a7": {"net": "PWM_R_3V3", "owner": "U1.IO14"}, "c11": {"net": "SERVO_L", "owner": "SVL.PWM"}, "c12": {"net": "SERVO_R", "owner": "SVR.PWM"}, "e13": {"net": "ESP_L_TX", "owner": "R1.1"}, "f13": {"net": "ML_RX", "owner": "R1.2"}, "e15": {"net": "ESP_R_TX", "owner": "R2.1"}, "f15": {"net": "MR_RX", "owner": "R2.2"}, "d5": {"net": "PWM_L_5V", "owner": "R3.1"}, "d11": {"net": "SERVO_L", "owner": "R3.2"}, "b8": {"net": "PWM_R_5V", "owner": "R4.1"}, "b12": {"net": "SERVO_R", "owner": "R4.2"}, "b4": {"net": "PWM_L_3V3", "owner": "R5.1"}, "T-4": {"net": "GND", "owner": "R5.2"}, "b7": {"net": "PWM_R_3V3", "owner": "R6.1"}, "T-7": {"net": "GND", "owner": "R6.2"}, "j3": {"net": "LOGIC5", "owner": "C1.1"}, "B-3": {"net": "GND", "owner": "C1.2"}, "a20": {"net": "IMU_SCK", "owner": "U1.IO18"}, "c20": {"net": "IMU_SCK", "owner": "IMU1.SCL"}, "a21": {"net": "IMU_MOSI", "owner": "U1.IO23"}, "c21": {"net": "IMU_MOSI", "owner": "IMU1.DI"}, "a22": {"net": "IMU_MISO", "owner": "U1.IO19"}, "c22": {"net": "IMU_MISO", "owner": "IMU1.SDA"}, "a23": {"net": "IMU_CS", "owner": "U1.IO27"}, "c23": {"net": "IMU_CS", "owner": "IMU1.CS"}, "a24": {"net": "IMU_INT", "owner": "U1.IO34"}, "c24": {"net": "IMU_INT", "owner": "IMU1.INT"}, "a25": {"net": "IMU_RST", "owner": "U1.IO32"}, "c25": {"net": "IMU_RST", "owner": "IMU1.RST"}, "a27": {"net": "TOF_SDA", "owner": "U1.IO21"}, "c27": {"net": "TOF_SDA", "owner": "TOF1.SDA"}, "a28": {"net": "TOF_SCL", "owner": "U1.IO22"}, "c28": {"net": "TOF_SCL", "owner": "TOF1.SCL"}, "T+1": {"net": "P3V3", "owner": "U1.3V3"}, "T-1": {"net": "GND", "owner": "U1.GND"}, "B+1": {"net": "LOGIC5", "owner": "F10.OUT"}, "B-1": {"net": "GND", "owner": "X0"}, "T+20": {"net": "P3V3", "owner": "IMU1.VIN"}, "T-20": {"net": "GND", "owner": "IMU1.GND"}, "T+21": {"net": "P3V3", "owner": "IMU1.P0"}, "T+22": {"net": "P3V3", "owner": "IMU1.P1"}, "T+23": {"net": "P3V3", "owner": "TOF1.VIN"}, "T-23": {"net": "GND", "owner": "TOF1.GND"}, "b3": {"net": "GND", "owner": "JMP1.1"}, "T-3": {"net": "GND", "owner": "JMP1.2"}, "b6": {"net": "GND", "owner": "JMP2.1"}, "T-6": {"net": "GND", "owner": "JMP2.2"}, "b9": {"net": "GND", "owner": "JMP3.1"}, "T-9": {"net": "GND", "owner": "JMP3.2"}, "h3": {"net": "LOGIC5", "owner": "JMP4.1"}, "B+3": {"net": "LOGIC5", "owner": "JMP4.2"}, "h4": {"net": "LOGIC5", "owner": "JMP5.1"}, "B+4": {"net": "LOGIC5", "owner": "JMP5.2"}, "h5": {"net": "GND", "owner": "JMP6.1"}, "B-5": {"net": "GND", "owner": "JMP6.2"}, "h7": {"net": "LOGIC5", "owner": "JMP7.1"}, "B+7": {"net": "LOGIC5", "owner": "JMP7.2"}, "h8": {"net": "GND", "owner": "JMP8.1"}, "B-8": {"net": "GND", "owner": "JMP8.2"}, "T-25": {"net": "GND", "owner": "JMP9.1"}, "B-25": {"net": "GND", "owner": "JMP9.2"}}, "placements": {"R1": ["e13", "f13"], "R2": ["e15", "f15"], "R3": ["d5", "d11"], "R4": ["b8", "b12"], "R5": ["b4", "T-4"], "R6": ["b7", "T-7"], "C1": ["j3", "B-3"]}, "jumpers": [["b3", "T-3"], ["b6", "T-6"], ["b9", "T-9"], ["h3", "B+3"], ["h4", "B+4"], ["h5", "B-5"], ["h7", "B+7"], ["h8", "B-8"], ["T-25", "B-25"]], "signalrows": [[20, "IMU_SCK", "IO18", "SCL"], [21, "IMU_MOSI", "IO23", "DI"], [22, "IMU_MISO", "IO19", "SDA"], [23, "IMU_CS", "IO27", "CS"], [24, "IMU_INT", "IO34", "INT"], [25, "IMU_RST", "IO32", "RST"], [27, "TOF_SDA", "IO21", "SDA"], [28, "TOF_SCL", "IO22", "SCL"]]}, "sources": [{"id": "S01", "title": "Smart-Cart repository / 2b4b8fea6909e4f76b4a52b02c5075c3f478097b", "url": "https://github.com/JTech-CO/Smart-Cart/tree/2b4b8fea6909e4f76b4a52b02c5075c3f478097b"}, {"id": "S02", "title": "Pololu G2 SMC user guide", "url": "https://www.pololu.com/docs/0J77/all"}, {"id": "S03", "title": "ESP32-DevKitC V4 power and J2/J3 pin tables", "url": "https://docs.espressif.com/projects/esp-dev-kits/en/latest/esp32/esp32-devkitc/user_guide.html"}, {"id": "S04", "title": "Adafruit BNO085 pinouts and SPI mode", "url": "https://learn.adafruit.com/adafruit-9-dof-orientation-imu-fusion-breakout-bno085/pinouts"}, {"id": "S05", "title": "Pololu VL53L1X carrier #3415", "url": "https://www.pololu.com/product/3415"}, {"id": "S06", "title": "Ai-Thinker BU04-Kit specification v1.1.0, p9 USB port", "url": "https://en.ai-thinker.com/Uploads/file/20241018/20241018150326_27432.pdf"}, {"id": "S07", "title": "TI SN74AHCT125 datasheet", "url": "https://www.ti.com/lit/ds/symlink/sn74ahct125.pdf"}, {"id": "S08", "title": "EasyEDA Standard document format", "url": "https://docs.easyeda.com/en/DocumentFormat/EasyEDA-Format-Standard/index.html"}, {"id": "S09", "title": "EasyEDA Pro import EasyEDA Standard JSON / ZIP", "url": "https://prodocs.easyeda.com/en/import-export/import-easyeda/"}, {"id": "S10", "title": "EasyEDA Pro KiCad 5.1 import", "url": "https://prodocs.easyeda.com/en/import-export/import-kicad/"}, {"id": "S11", "title": "Infineon BTS7960 operating voltage", "url": "https://www.infineon.com/dgdl/BTS7960_Datasheet.pdf"}, {"id": "S12", "title": "SLAMTEC C1 datasheet", "url": "https://d229kd5ey79jzj.cloudfront.net/3157/SLAMTEC_rplidar_datasheet_C1_v1.0_en.pdf"}]};
